JeffGregorio/ActuatedDrums/Hardware/untitled.brd

## EAGLE design Hardware/untitled.brd (2017-08-22)

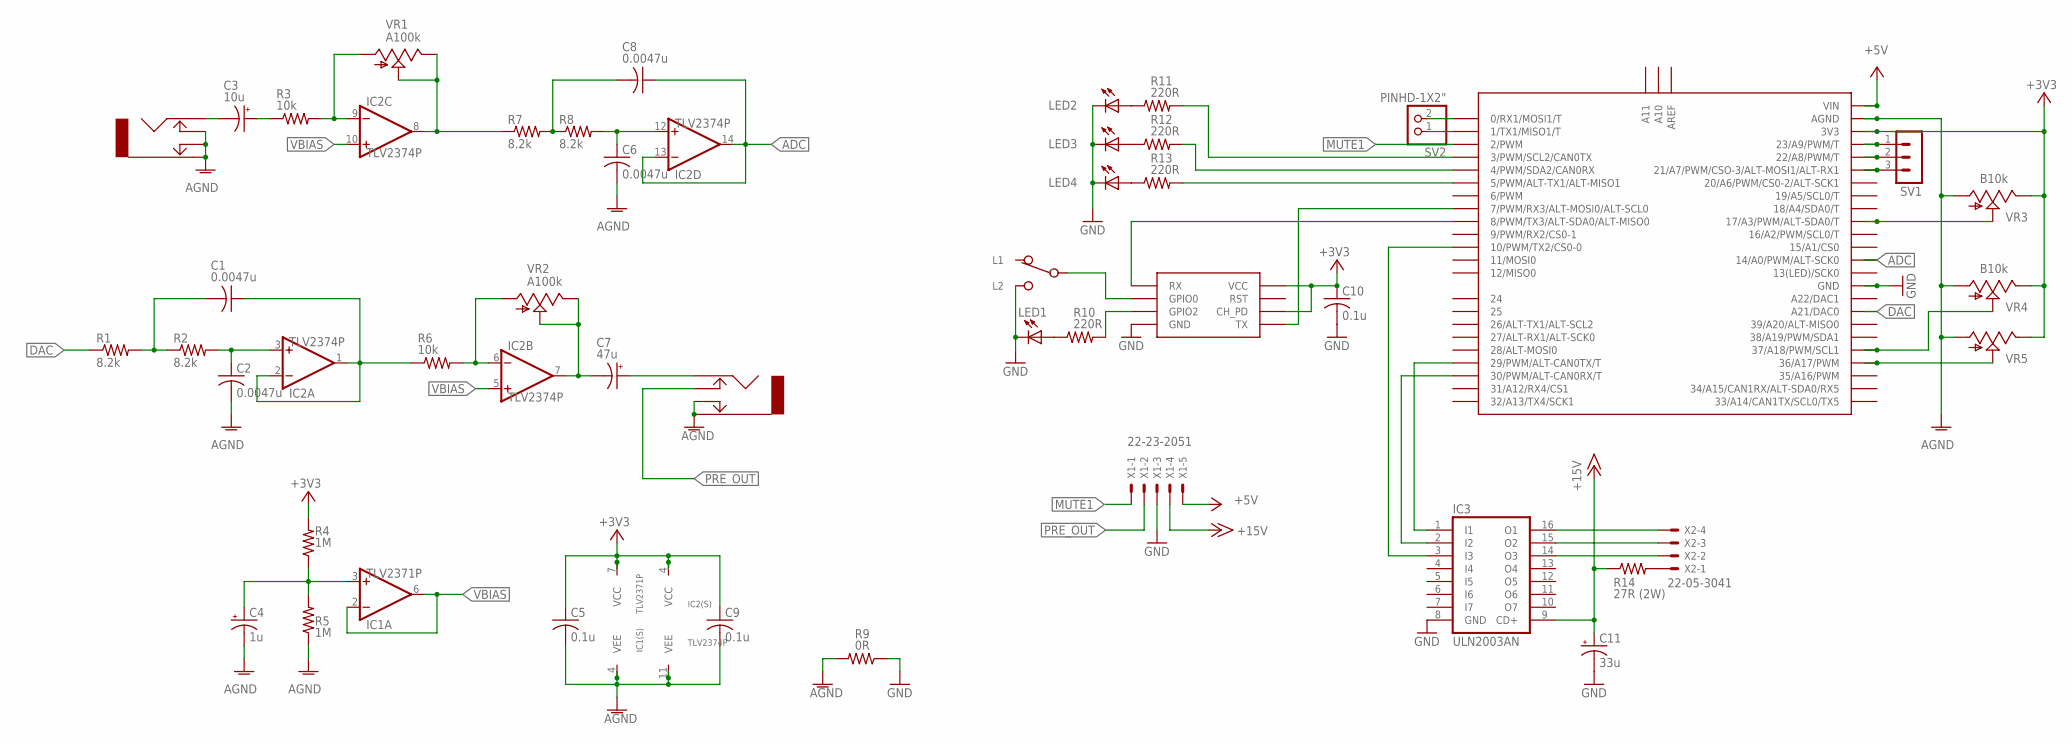
[picture p1: schematic untitled.sch, sheet 1, Preamplifier]

Parts:
C1, C2, C6, C8: 0.0047u; C-050-035X075
C3: 10u; E2,5-6
C4: 1u; E2,5-6
C5, C9, C10: 0.1u; C-050-035X075
C7: 47u; E2,5-5
C11: 33u; E2,5-5
IC1: TLV2371P; DIL08
IC2: TLV2374P; DIL14
IC3: ULN2003AN; DIL16
J1, J2: JACK-NYS2162
LED1, LED2, LED3, LED4: TLLR4400; LED3MM
MCU1: ESP8266-01
MCU2: TEENSY-3.6; T36--OUTERPINS
R1, R2, R7, R8: 8.2k; 0207/7
R3, R6: 10k; 0207/7
R4, R5: 1M; 0207/7
R9: 0R; 0207/7
R10, R11, R12, R13: 220R; 0207/7
R14: 27R (2W); 0411/12
S1: SPDT-SLIDE
SV1: MA03-1
SV2: PINHD-1X2"; 1X02
VR1, VR2: A100k; RV09AF
VR3, VR4, VR5: B10k; RV09AF
X1: 22-23-2051
X2: 22-05-3041

Connections:
+3V3: C5.1, C9.1, C10.1, IC1.7 (VCC), IC2.4 (VCC), MCU1.CH_PD, MCU1.VCC, MCU2.3V3(1) (3V3), MCU2.3V3(2) (3V3), R4.2, VR3.E, VR4.E, VR5.E
+5V: MCU2.VIN, X1.5; also elsewhere on the board
+15V: C11.+, IC3.9 (CD+), R14.1, X1.4; also elsewhere on the board
ADC: C8.1, IC2.13 (IN-), IC2.14 (OUT), MCU2.14 (14/A0/PWM/ALT-SCK0)
AGND: C2.2, C4.-, C5.2, C6.2, C9.2, IC1.4 (VEE), IC2.11 (VEE), J1.S, J1.SN, J1.TN, J2.S, J2.SN, MCU2.AGND, R5.1, R9.2, VR3.A, VR4.A, VR5.A
DAC: MCU2.DAC0 (A21/DAC0), R1.1
GND: C10.2, C11.-, IC3.8 (GND), LED1.K (C), LED2.K (C), LED3.K (C), LED4.K (C), MCU1.GND, MCU2.GND(1) (GND), MCU2.GND(2) (GND), R9.1, S1.L2, X1.3; also elsewhere on the board
MUTE1: MCU2.2 (2/PWM), X1.1; also elsewhere on the board
unnamed: C3.+, R3.1
unnamed: IC2.9 (IN-), R3.2, VR1.A
unnamed: C8.2, R7.2, R8.1
unnamed: C6.1, IC2.12 (IN+), R8.2
unnamed: C1.1, IC2.1 (OUT), IC2.2 (IN-), R6.1
unnamed: C1.2, R1.2, R2.1
unnamed: C2.1, IC2.3 (IN+), R2.2
unnamed: IC2.6 (IN-), R6.2, VR2.A
unnamed: C7.-, IC2.7 (OUT), VR2.E, VR2.S
unnamed: IC2.8 (OUT), R7.1, VR1.E, VR1.S
unnamed: C4.+, IC1.3 (IN+), R4.1, R5.2
unnamed: MCU1.GPIO2, R10.2
unnamed: MCU1.TX, MCU2.7 (7/PWM/RX3/ALT-MOSI0/ALT-SCL0)
unnamed: MCU1.RX, MCU2.8 (8/PWM/TX3/ALT-SDA0/ALT-MISO0)
unnamed: MCU1.GPIO0, S1.C
unnamed: LED1.A, R10.1
unnamed: MCU2.36 (36/A17/PWM), VR5.S
unnamed: LED4.A, R13.1
unnamed: LED3.A, R12.1
unnamed: LED2.A, R11.1
unnamed: MCU2.5 (5/PWM/ALT-TX1/ALT-MISO1), R13.2
unnamed: MCU2.4 (4/PWM/SDA2/CAN0RX), R12.2
unnamed: MCU2.3 (3/PWM/SCL2/CAN0TX), R11.2
unnamed: C3.-, J1.T
unnamed: C7.+, J2.T
unnamed: MCU2.37 (37/A18/PWM/SCL1), VR4.S
unnamed: R14.2, X2.1
unnamed: IC3.16 (O1), X2.4
unnamed: IC3.15 (O2), X2.3
unnamed: IC3.14 (O3), X2.2
unnamed: IC3.3 (I3), MCU2.10 (10/PWM/TX2/CS0-0)
unnamed: IC3.2 (I2), MCU2.30 (30/PWM/ALT-CAN0RX/T)
unnamed: IC3.1 (I1), MCU2.29 (29/PWM/ALT-CAN0TX/T)
unnamed: MCU2.23 (23/A9/PWM/T), SV1.1
unnamed: MCU2.22 (22/A8/PWM/T), SV1.2
unnamed: MCU2.21 (21/A7/PWM/CSO-3/ALT-MOSI1/ALT-RX1), SV1.3
unnamed: MCU2.17 (17/A3/PWM/ALT-SDA0/T), VR3.S
unnamed: MCU2.1 (1/TX1/MISO1/T), SV2.1
unnamed: MCU2.0 (0/RX1/MOSI1/T), SV2.2
PRE_OUT: J2.TN, X1.2; also elsewhere on the board
VBIAS: IC1.2 (IN-), IC1.6 (OUT), IC2.5 (IN+), IC2.10 (IN+)

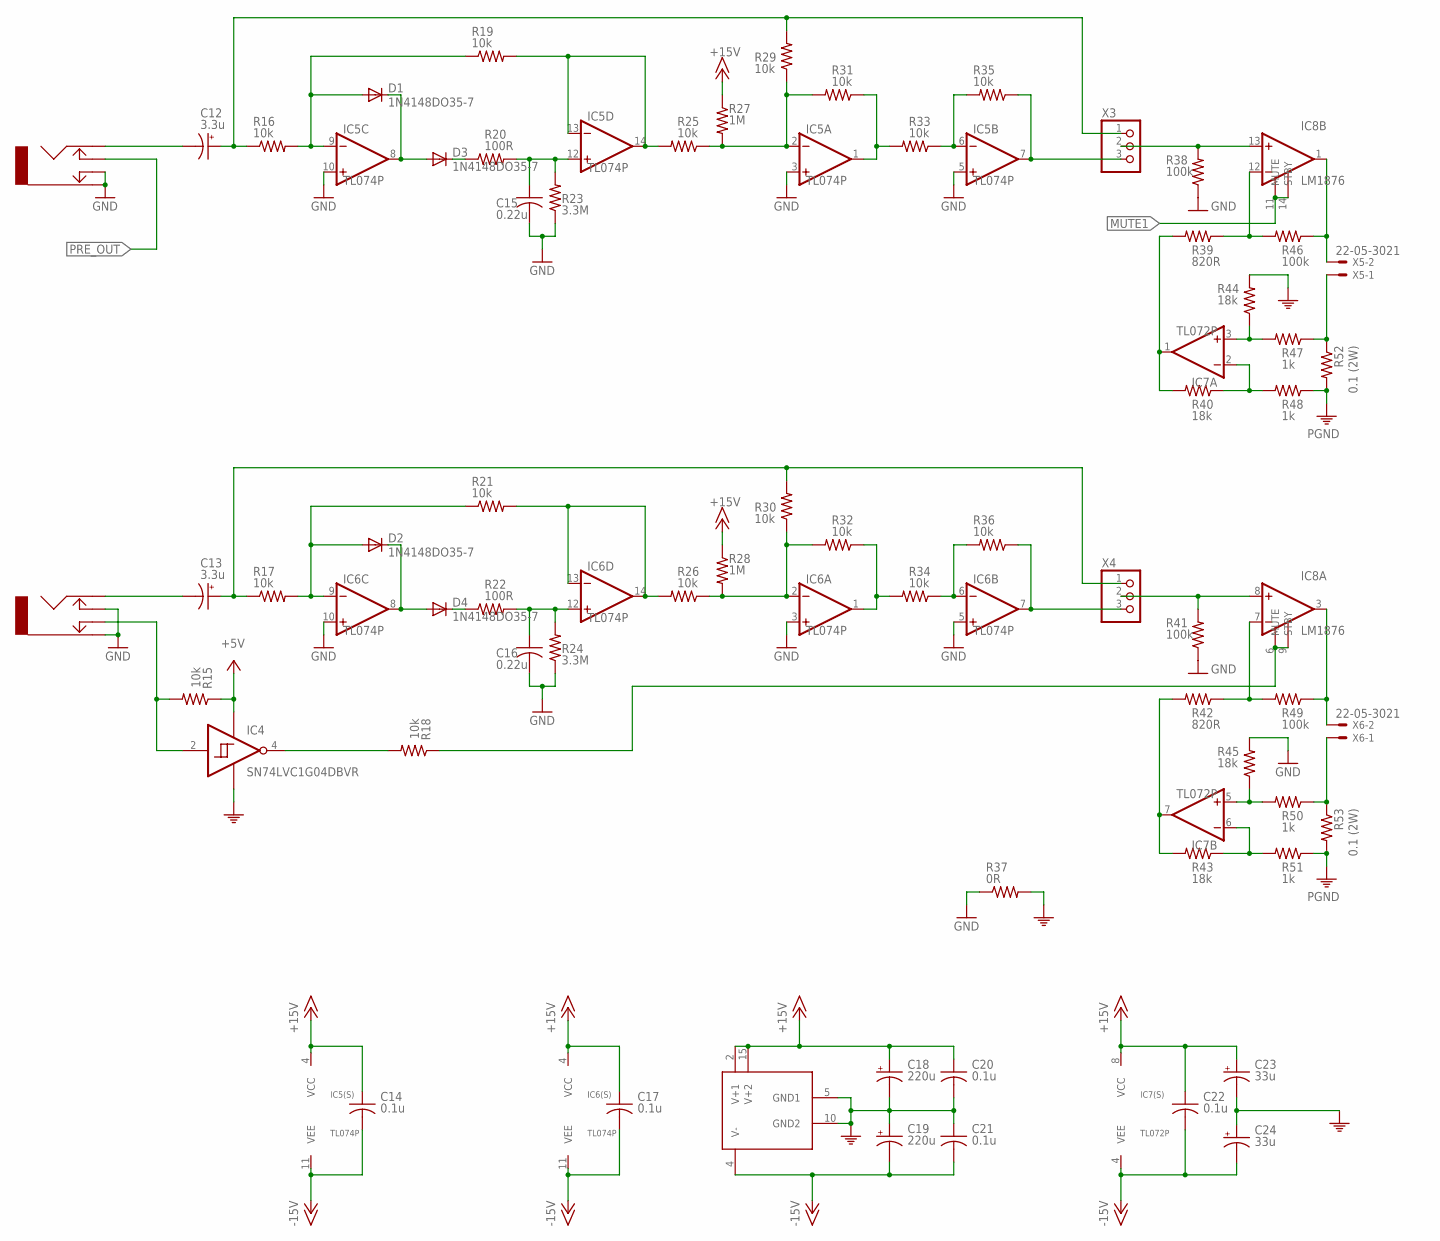
[picture p2: schematic untitled.sch, sheet 2, Power Amplifier]

Parts:
C12, C13: 3.3u; E2,5-5
C14, C17, C20, C21, C22: 0.1u; C-050-035X075
C15, C16: 0.22u; C-075-052X106
C18, C19: 220u; E5-10,5
C23, C24: 33u; E2,5-5
D1, D2, D3, D4: 1N4148DO35-7; DO35-7
IC4: SN74LVC1G04DBVR; SOT23-5
IC5, IC6: TL074P; DIL14
IC7: TL072P; DIL08
IC8: LM1876; MULTIWATT15
J3: CH1; JACK-NYS2162
J4: CH2; JACK-NYS2162
R15, R16, R17, R18, R19, R21, R25, R26, R29, R30, R31, R32, R33, R34, R35, R36: 10k; 0207/7
R20, R22: 100R; 0207/7
R23, R24: 3.3M; 0207/7
R27, R28: 1M; 0207/7
R37: 0R; 0207/7
R38, R41, R46, R49: 100k; 0207/7
R39, R42: 820R; 0207/7
R40, R43, R44, R45: 18k; 0207/7
R47, R48, R50, R51: 1k; 0207/7
R52, R53: 0.1 (2W); 0411/12
X3, X4: PINHD-1X3; 1X03
X5, X6: 22-05-3021

Connections:
+5V: IC4.5 (VCC), R15.1; also elsewhere on the board
+15V: C14.1, C17.1, C18.+, C20.1, C22.1, C23.+, IC5.4 (VCC), IC6.4 (VCC), IC7.8 (VCC), IC8.2 (V+1), IC8.15 (V+2), R27.1, R28.1; also elsewhere on the board
-15V: C14.2, C17.2, C19.-, C21.2, C22.2, C24.-, IC5.11 (VEE), IC6.11 (VEE), IC7.4 (VEE), IC8.4 (V-); also elsewhere on the board
GND: C15.2, C16.2, IC5.3 (IN+), IC5.5 (IN+), IC5.10 (IN+), IC6.3 (IN+), IC6.5 (IN+), IC6.10 (IN+), J3.S, J3.SN, J4.S, J4.TN, R23.1, R24.1, R37.1, R38.1, R41.1, R45.2; also elsewhere on the board
INPUT1: IC5.7 (OUT), R35.1, X3.3
INPUT2: IC6.7 (OUT), R36.1, X4.3
MUTE1: IC8.11 (MUTE), IC8.14 (STBY); also elsewhere on the board
MUTE2: IC8.6 (MUTE), IC8.9 (STBY), R18.1
unnamed: IC7.1 (OUT), R39.2, R40.2
unnamed: IC8.12 (-IN), R39.1, R46.2
unnamed: IC8.1 (OUT), R46.1, X5.2
unnamed: IC7.3 (IN+), R44.1, R47.2
unnamed: IC7.2 (IN-), R40.1, R48.2
unnamed: IC7.5 (IN+), R45.1, R50.2
unnamed: R47.1, R52.1, X5.1
unnamed: R50.1, R53.1, X6.1
unnamed: IC8.7 (-IN), R42.1, R49.2
unnamed: IC7.6 (IN-), R43.1, R51.2
unnamed: IC8.3 (OUT), R49.1, X6.2
unnamed: IC7.7 (OUT), R42.2, R43.2
unnamed: D1.A, IC5.9 (IN-), R16.2, R19.1
unnamed: D3.C, R20.1
unnamed: C15.1, IC5.12 (IN+), R20.2, R23.2
unnamed: D2.A, IC6.9 (IN-), R17.2, R21.1
unnamed: D1.C, D3.A, IC5.8 (OUT)
unnamed: C12.+, R16.1, R29.2, X3.1
unnamed: IC5.2 (IN-), R25.1, R27.2, R29.1, R31.2
unnamed: IC5.1 (OUT), R31.1, R33.2
unnamed: IC5.6 (IN-), R33.1, R35.2
unnamed: C13.+, R17.1, R30.2, X4.1
unnamed: IC5.13 (IN-), IC5.14 (OUT), R19.2, R25.2
unnamed: IC6.1 (OUT), R32.1, R34.2
unnamed: IC6.6 (IN-), R34.1, R36.2
unnamed: IC6.13 (IN-), IC6.14 (OUT), R21.2, R26.2
unnamed: D4.C, R22.1
unnamed: D2.C, D4.A, IC6.8 (OUT)
unnamed: IC6.2 (IN-), R26.1, R28.2, R30.1, R32.2
unnamed: C16.1, IC6.12 (IN+), R22.2, R24.2
unnamed: C12.-, J3.T
unnamed: IC8.8 (+IN), R41.2, X4.2
unnamed: C13.-, J4.T
unnamed: IC8.13 (+IN), R38.2, X3.2
unnamed: IC4.2 (A), J4.SN, R15.2
unnamed: IC4.4 (Y), R18.2
PGND: C18.-, C19.+, C20.2, C21.1, C23.-, C24.+, IC4.3 (GND), IC8.5 (GND1), IC8.10 (GND2), R37.2, R44.2, R48.1, R51.1, R52.2, R53.2; also elsewhere on the board
PRE_OUT: J3.TN; also elsewhere on the board

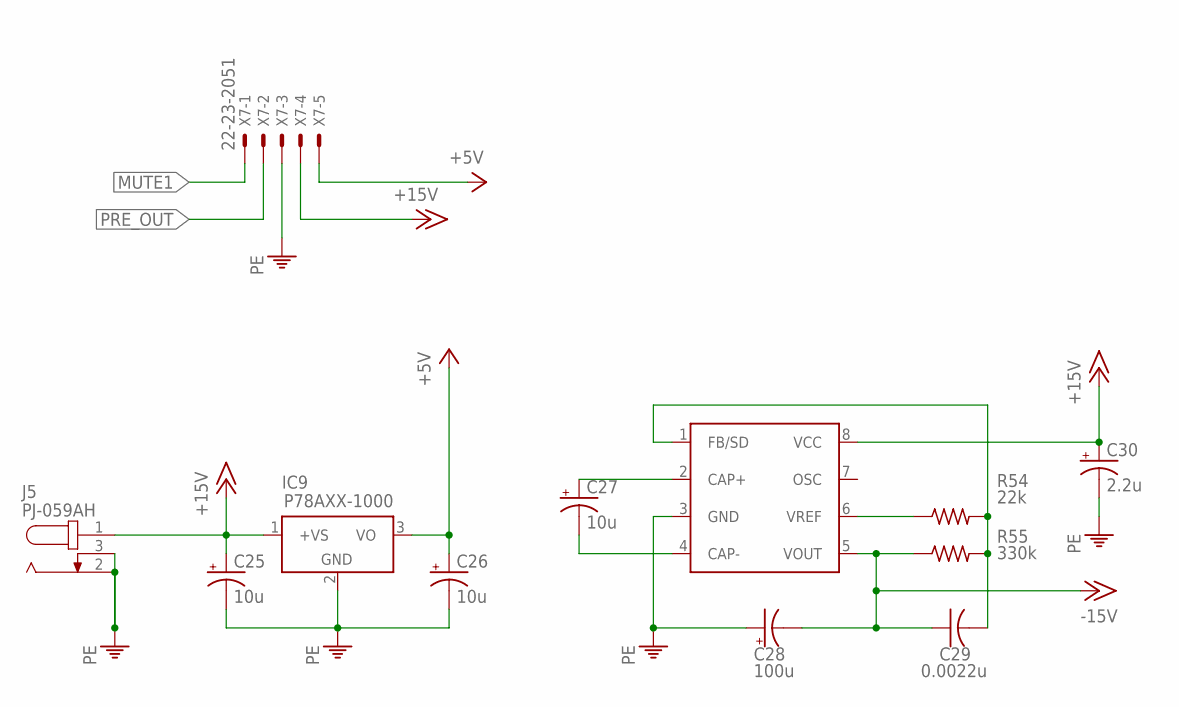
[picture p3: schematic untitled.sch, sheet 3, Power Supply]

Parts:
C25, C26, C27: 10u; CPOL-025-050X050
C28: 100u; E2,5-6
C29: 0.0022u; C050-035X075
C30: 2.2u; E2-5
IC9: P78AXX-1000
IC10: LT1054; DIL08
J5: PJ-059AH; JACK-PJ-059AH
R54: 22k; 0207/7
R55: 330k; 0207/7
X7: 22-23-2051

Connections:
+5V: C26.+, IC9.3 (VO), X7.5; also elsewhere on the board
+15V: C25.+, C30.+, IC9.1 (+VS), IC10.8 (VCC), J5.1, X7.4; also elsewhere on the board
-15V: C28.-, C29.1, IC10.5 (VOUT), R55.1; also elsewhere on the board
MUTE1: X7.1; also elsewhere on the board
unnamed: C27.+, IC10.2 (CAP+)
unnamed: C27.-, IC10.4 (CAP-)
unnamed: IC10.6 (VREF), R54.1
unnamed: C29.2, IC10.1 (FB/SD), R54.2, R55.2
PGND: C25.-, C26.-, C28.+, C30.-, IC9.2 (GND), IC10.3 (GND), J5.2, J5.3, X7.3; also elsewhere on the board
PRE_OUT: X7.2; also elsewhere on the board

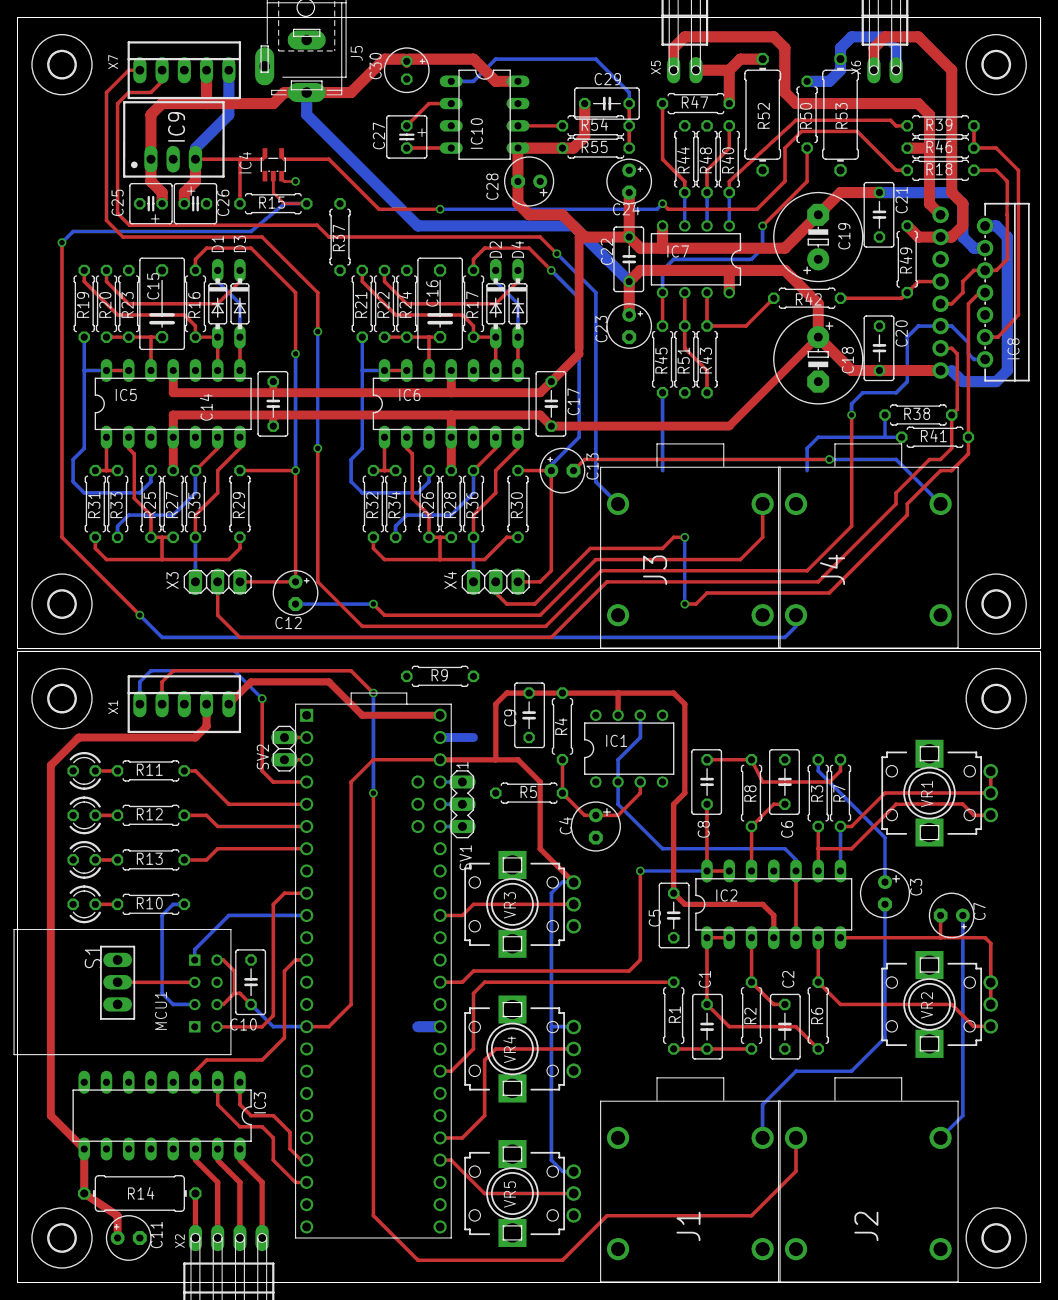
[picture p4: board untitled.brd from above]

Board: 2 copper layers, 116.8 x 144.4 mm, 133 parts (0 on the bottom side), 94 nets.

Other parts of the board:
U$1, U$2, U$3, U$4, U$5, U$6, U$7, U$8: 3,0
